jonasbjurel/RailWayHW/Canbus/railpican/railpican-P1A/partlist-Elfa.xls

Quantity | Distrelec Article Number | Reference | Manufacturer | Manufacturer Article Number | Name | Availability | Stock | Expired On | orderCode | My Single Price | My Subtotal
2 | 16569347 |  | Hitano | HB2H561K-L515B | Capacitor 560 pF 500 VDC 5 mm | 24 h | 1079 |  | 1001183267 | Skr0.95 | Skr1.90
2 | 16569149 |  | Hitano | TCH2H220J-L515B | Capacitor 22 pF 500 VDC 5 mm | 24 h | 4353 |  | 1001183267 | Skr0.91 | Skr1.81
1 | 16059249 |  | Vishay | MBB02070C1802FCT00 | Resistor 18 kOhm 0.6 W ± 1 % | 24 h | 5634 |  | 1001183267 | Skr0.82 | Skr0.82
2 | 16059231 |  | Vishay | MBB02070C4701FCT00 | Resistor 4.7 kOhm 0.6 W ± 1 % | 24 h | 41576 |  | 1001183267 | Skr0.83 | Skr1.65
1 | 16059239 |  | Vishay | MBB02070C1002FCT00 | Resistor 10 kOhm 0.6 W ± 1 % | 24 h | 7276 |  | 1001183267 | Skr0.82 | Skr0.82
2 | 16059189 |  | Vishay | MBB02070C1000FCT00 | Resistor 100 Ohm 0.6 W ± 1 % | 24 h | 10312 |  | 1001183267 | Skr0.83 | Skr1.65
1 | 16059191 |  | Vishay | MBB02070C1200FCT00 | Resistor 120 Ohm 0.6 W ± 1 % | 24 h | 34365 |  | 1001183267 | Skr0.82 | Skr0.82
2 | 16059214 |  | Vishay | MBB02070C1001FCT00 | Resistor 1 kOhm 0.6 W ± 1 % | 24 h | 749017 |  | 1001183267 | Skr0.83 | Skr1.65
1 | 17451701 |  | IQD | LFXTAL003240 | Quartz HC49/4H 16 MHz | 24 h | 3748 |  | 1001183267 | Skr2.88 | Skr2.88
1 | 17309560 |  | ST | L78S05CV | Linear voltage regulator 5 V TO-220 | 24 h | 1830 |  | 1001183267 | Skr6.82 | Skr6.82
1 | 17387002 |  | Microchip | MCP2515-I/P | Controller IC CAN v2.0B / SPI DIL-18 | 24 h | 63 |  | 1001183267 | Skr15.60 | Skr15.60
1 | 17386817 |  | Microchip | MCP2551-I/P | Transceiver IC CAN High Speed DIL-8 | 24 h | 2438 |  | 1001183267 | Skr8.74 | Skr8.74
4 | 12450887 |  | Fischer Elektronik | CAB4GS | Jumper 2.54 mm Black | 24 h | 1551 |  | 1001183267 | Skr1.13 | Skr4.50
1 | 14370219 |  | Prostar | SS-1X36-T1-7/3MM | Straight pin header Male 36 | 24 h | 26933 |  | 1001183267 | Skr6.14 | Skr6.14
1 | 14416350 |  | TE Connectivity | 5747844-4 | D-Sub female 9P, Female | 24 h | 762 |  | 1001183267 | Skr25.40 | Skr25.40
1 | 17501224 |  | Everlight Electronics | 264-7SURD/S530-A3 | LED 3 mm (T1) Red | 24 h | 23316 |  | 1001183267 | Skr3.26 | Skr3.26
1 | 17510152 |  | Vishay Telefunken | TLHG 4600 | LED 3 mm (T1) Green | 24 h | 3601 |  | 1001183267 | Skr2.21 | Skr2.21
2 | 17003619 |  | No Brand | 1N5401 | Rectifier diode 100 V 3 A DO-201 | 24 h | 5433 |  | 1001183267 | Skr1.49 | Skr2.97
2 | 11046377 |  | Rubycon | 100PX47MT78X11.5 | Aluminium Electrolytic Capacitor 47 uF 100 VDC | 24 h | 488 |  | 1001183267 | Skr2.91 | Skr5.82
2 | 16716492 |  | Jamicon | TKP0R1M2AD11ME4 | Aluminium Electrolytic Capacitor 100 nF 100 VDC | 24 h | 1646 |  | 1001183267 | Skr0.77 | Skr1.54
1 | 14833634 |  | Phoenix Contact | 1715048 | PCB Terminal Block Pitch 5 mm Horizontal 4P | 24 h | 263 |  | 1001183267 | Skr15.00 | Skr15.00
1 | 17558604 |  | Fischer Elektronik | FK 242 SA 220 O | Heat sink 15.2 mm 26 K/W black anodised | 24 h | 272 |  | 1001183267 | Skr6.34 | Skr6.34
1 | 14384015 |  | Preci-Dip | 803-87-040-10-001101 | Pin header Female 40 | 24 h | 228 |  | 1001183267 | Skr31.40 | Skr31.40
1 | 17503121 |  | Vishay Telefunken | TLHY 4400 | LED 3 mm (T1) Yellow | 24 h | 2714 |  | 1001183267 | Skr1.82 | Skr1.82
