jonasbjurel/RailWayHW/Canbus/railpican/railpican-P1A/railpican.kicad_pcb

## KiCad design Canbus/railpican/railpican-P1A/railpican.kicad_pcb (2019-11-24)

Schematic: railpican.sch, RAIL-PICAN

Parts:
C1: CONN_02X20; Socket_Strip_Straight_2x20
C2: 0.1uF; CP_Radial_D5.0mm_P2.00mm
C3, C8: 47uF; CP_Radial_D8.0mm_P3.50mm
C4, C5: 560pF; C_Disc_D8.0mm_W2.5mm_P5.00mm
C6, C7: 22 pF; C_Disc_D8.0mm_W2.5mm_P5.00mm
D1, D3: 1N5401; D_DO-201_P12.70mm_Horizontal
D2: GREEN; LED_D3.0mm
D4: YELLOW; LED_D3.0mm
D5: RED; LED_D3.0mm
J1: Screw_Terminal_1x04; TerminalBlock_Pheonix_MKDS1.5-4pol
J2: DB9; DB9FD
JP1: JP1; Pin_Header_Straight_1x03_Pitch2.54mm
JP2: JP2; Pin_Header_Straight_1x02_Pitch2.54mm
JP3: JP3; Pin_Header_Straight_1x03_Pitch2.54mm
JP4: JP4; Pin_Header_Straight_1x03_Pitch2.54mm
R1: 18k; R_Box_L8.4mm_W2.5mm_P5.08mm
R2, R4: 4k7; R_Box_L8.4mm_W2.5mm_P5.08mm
R3: 10k; R_Box_L8.4mm_W2.5mm_P5.08mm
R5, R8, R10: 1k; R_Box_L8.4mm_W2.5mm_P5.08mm
R6, R7: 100; R_Box_L8.4mm_W2.5mm_P5.08mm
R9: 120; R_Box_L8.4mm_W2.5mm_P5.08mm
U1: MCP2515-E/ST-DIP; DIP-18_W7.62mm
U2: 78S05; TO-220
U3: MCP2551-I/P; DIP-8_W7.62mm
Y1: Crystal; Crystal_HC49-4H_Vertical
c1: 0.1uF; CP_Radial_D5.0mm_P2.00mm

Connections:
+12V: D1.2 (A), J1.4, J2.9
CANH: J1.3, JP2.2, JP3.2, R7.1, U3.7 (CANH)
CANL: J1.2, JP1.2, R6.1, R9.2, U3.6 (CANL)
GND: C1.6, C1.9, C1.14, C1.20, C1.30, C1.34, C1.39, C2.2, C3.2, C4.2, C5.2, C6.2, C7.2, C8.2, J1.1, JP4.2, R1.2, R4.2, R5.1, R8.1, R10.1, U1.9 (VSS), U2.2, U3.2 (VSS), c1.2
unnamed: C3.1, D3.2 (A), D4.2 (A), U2.3
unnamed: C4.1, R6.2
unnamed: C5.1, R7.2
unnamed: C8.1, D1.1 (K), U2.1
unnamed: D2.1 (K), R5.2
unnamed: D4.1 (K), R8.2
unnamed: D5.1 (K), R10.2
unnamed: J2.2, JP1.3, JP4.1
unnamed: J2.3, JP3.1, JP4.3
unnamed: J2.5, JP1.1
unnamed: J2.7, JP3.3
unnamed: JP2.1, R9.1
unnamed: R1.1, R3.2, U1.2 (RXCAN)
unnamed: R3.1, U3.4 (RXD)
unnamed: R4.1, U3.8 (Rs)
unnamed: U1.1 (TXCAN), U3.1 (TXD)
OSC1: C6.1, U1.8 (OSC1), Y1.1
OSC2: C7.1, U1.7 (OSC2), Y1.2
PI_3V3: C1.1, C1.17, C2.1, R2.2, U1.18 (VDD)
PI_5V: C1.2, C1.4, D2.2 (A), D3.1 (K), U3.3 (VDD), c1.1
PI_SPI_MISO: C1.21, U1.15 (SO)
PI_SPI_MOSI: C1.19, U1.14 (SI)
PI_SPI_SCLK: C1.23, U1.13 (SCK)
RST: R2.1, U1.17 (~RESET)
~PI_SPI_CE0: C1.24, U1.16 (~CS)
~PI_SPI_CE1: C1.26, D5.2 (A)

Notes on the sheet:
PI connect
Power supply
Timing
CAN Activity
CANBus Logic
CAN-Interface
Control
ODBII
TERMINATION
Description
Jumper settings:
LED description:
Debug
D5 - RED: CANBUS RX/TX activity
D4 - YELLOW: +12V CANBUS Power (PI Powered by CANBUS)
D2 - GREEN: +5V PICAN HAT POWER
JP2 - CANBUS Termination: Open-No termination; Closed-R120 termination
CANBUS Termination:
CANBUS DB9 Pinout standard:
JP1:
JP3:
JP4:
(1-2)
(2-3)
2-GND; 3-CANH; 5-CANL; 9-12V+
2-CANL; 3-GND; 7-CANH; 9-12V+
DB9:
1-GND; 2-CANL; 3-CANH; 4-12V+
Screw terminal:
N/A
T.B.D.

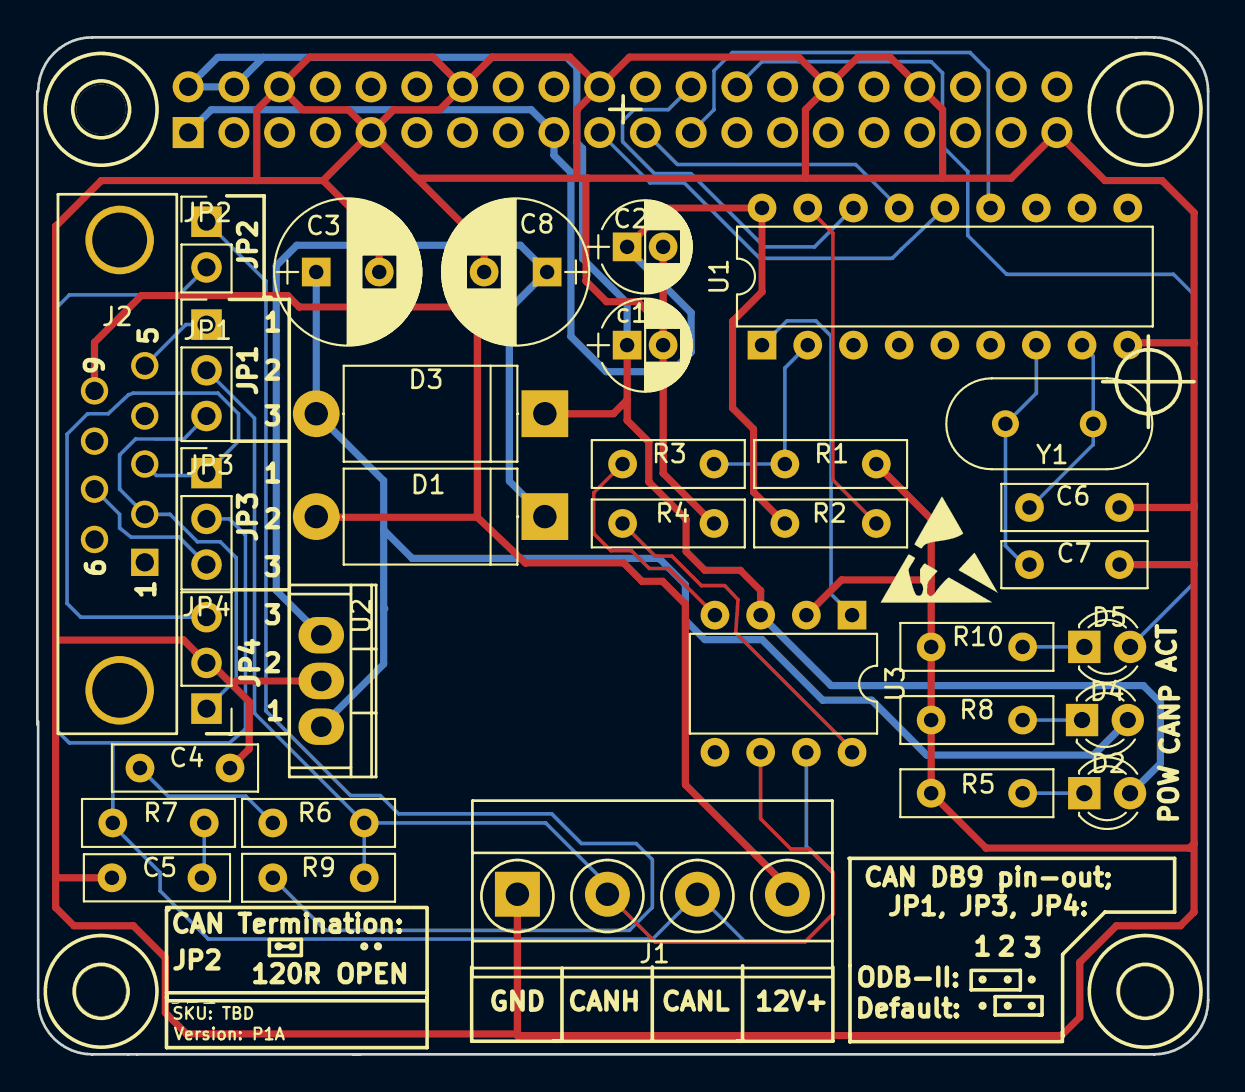
[picture p6: board railpican.kicad_pcb from above]

Board: 2 copper layers, 65.0 x 56.5 mm, 38 parts (1 on the bottom side), 30 nets.

Other parts of the board:
H1, H2, H3, H4: DRILL; dsk-drill-rpi-hat
