jonasbjurel/RailWayHW/hat-design-master/hat-design-master/hat-design.kicad_pcb

## KiCad design hat-design-master/hat-design-master/hat-design.kicad_pcb (2019-11-24)

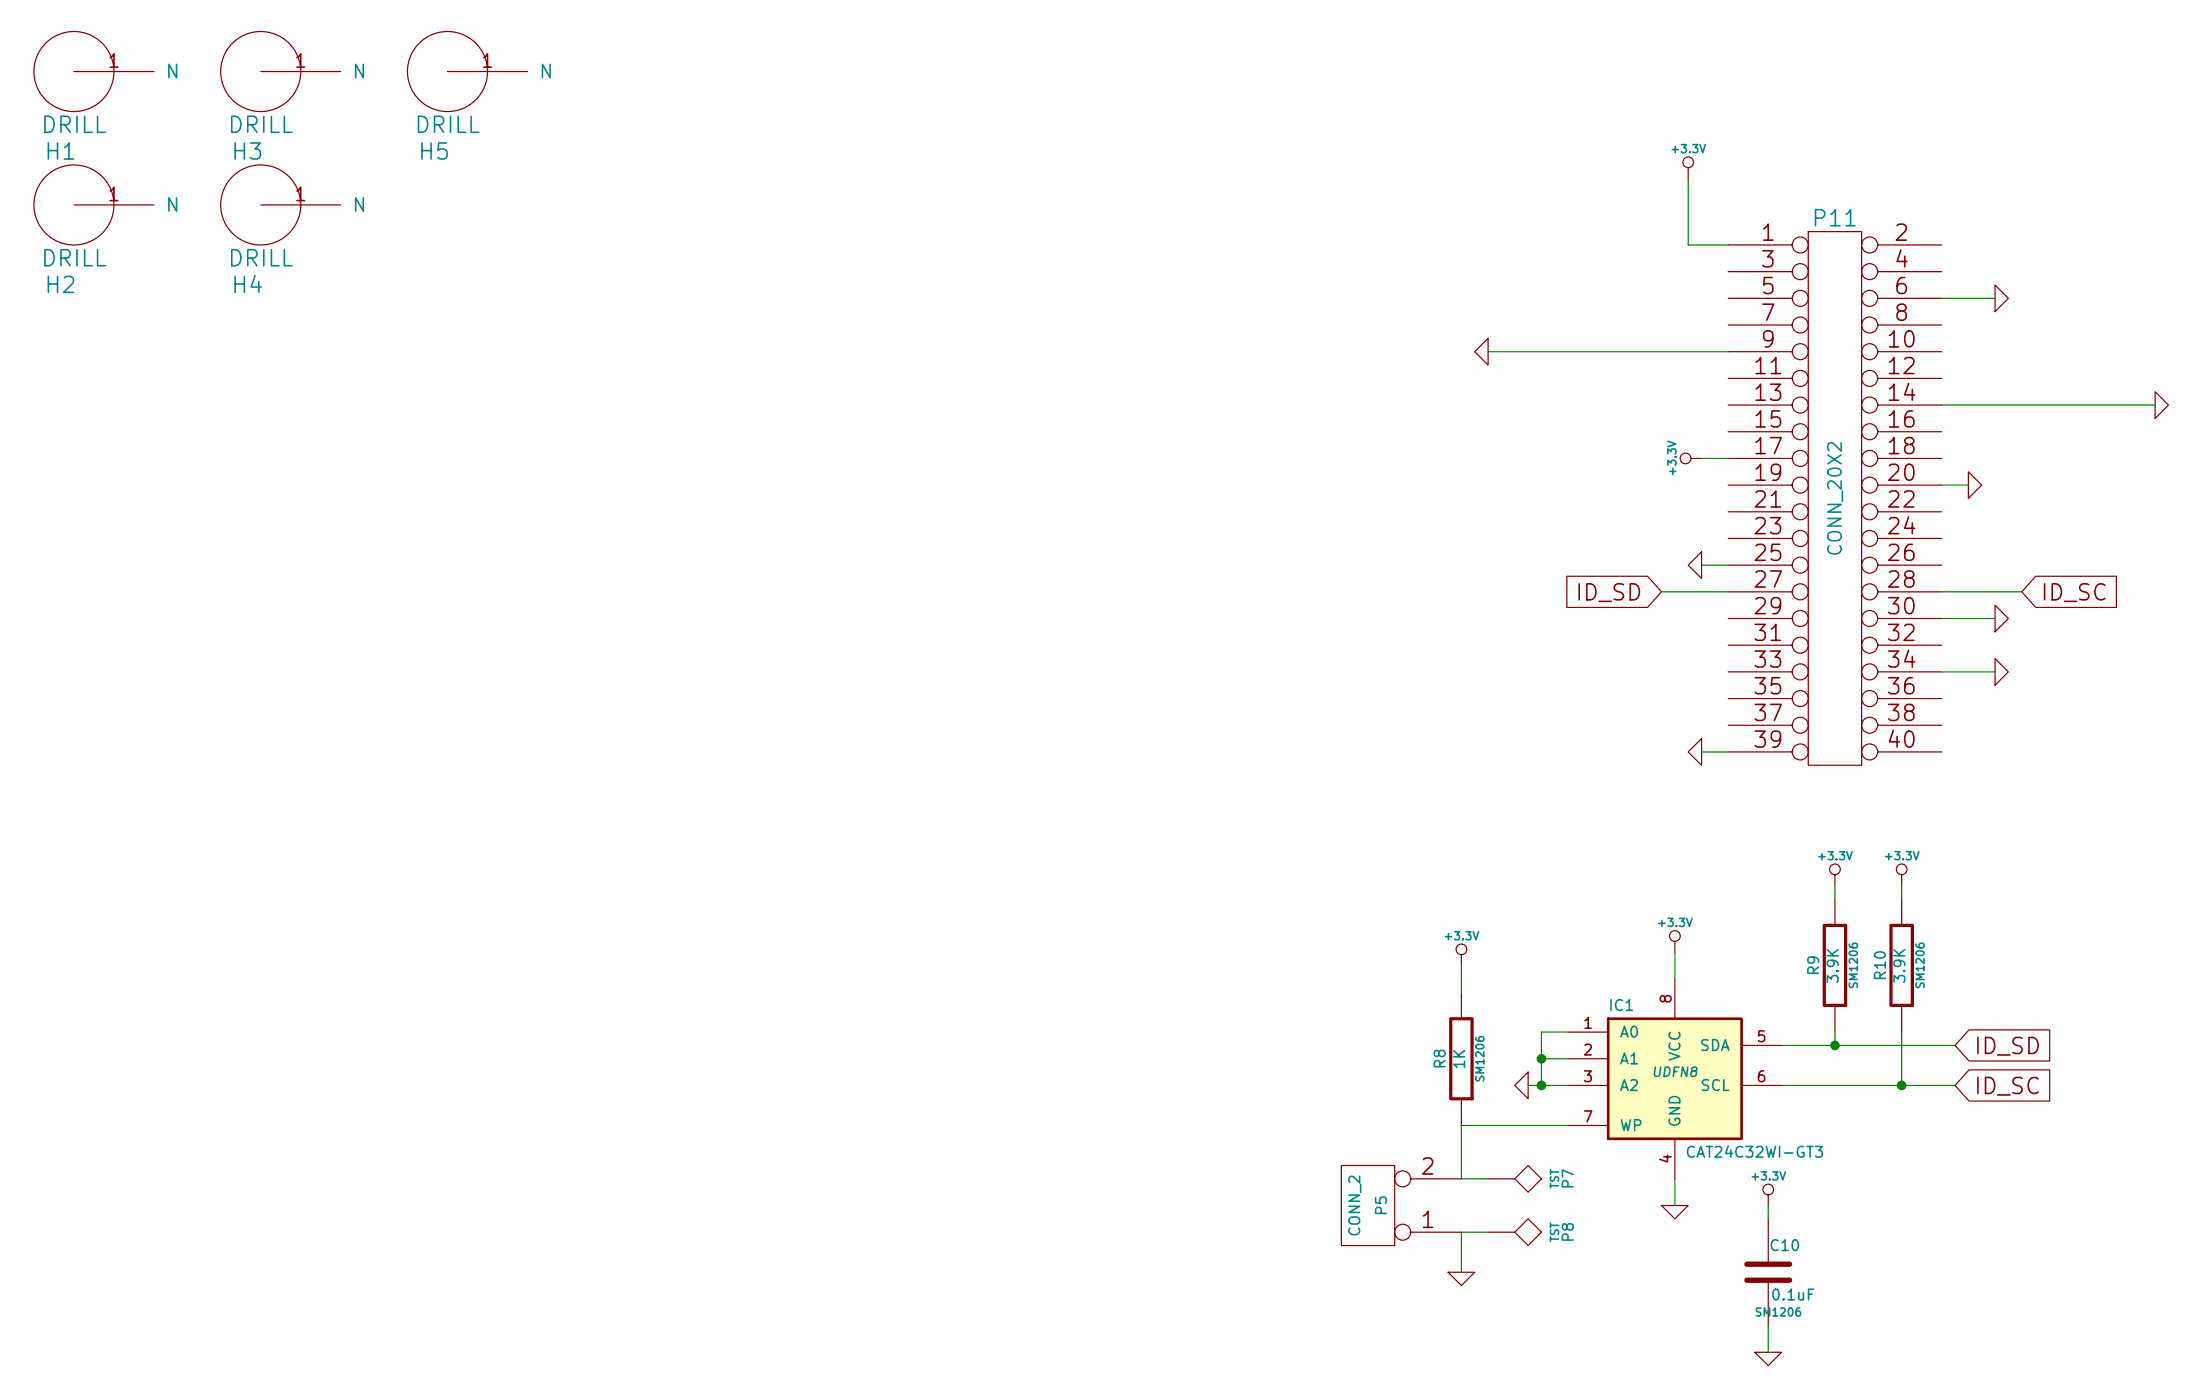
[picture p7: schematic hat-design.sch]

Parts:
C10: 0.1uF; SM1206
H1, H2, H3, H4, H5: DRILL
IC1: CAT24C32WI-GT3; UDFN8
P5: CONN_2
P7, P8: TST
P11: CONN_20X2
R8: 1K; SM1206
R9, R10: 3.9K; SM1206

Connections:
+3.3V: C10.1, IC1.8 (VCC), P11.1, P11.17, R8.2, R9.2, R10.2
GND: C10.2, IC1.1 (A0), IC1.2 (A1), IC1.3 (A2), IC1.4 (GND), P5.1, P8.1, P11.6, P11.9, P11.14, P11.20, P11.25, P11.30, P11.34, P11.39
ID_SC: IC1.6 (SCL), P11.28, R10.1
ID_SD: IC1.5 (SDA), P11.27, R9.1
unnamed: IC1.7 (WP), P5.2 (PM), P7.1, R8.1

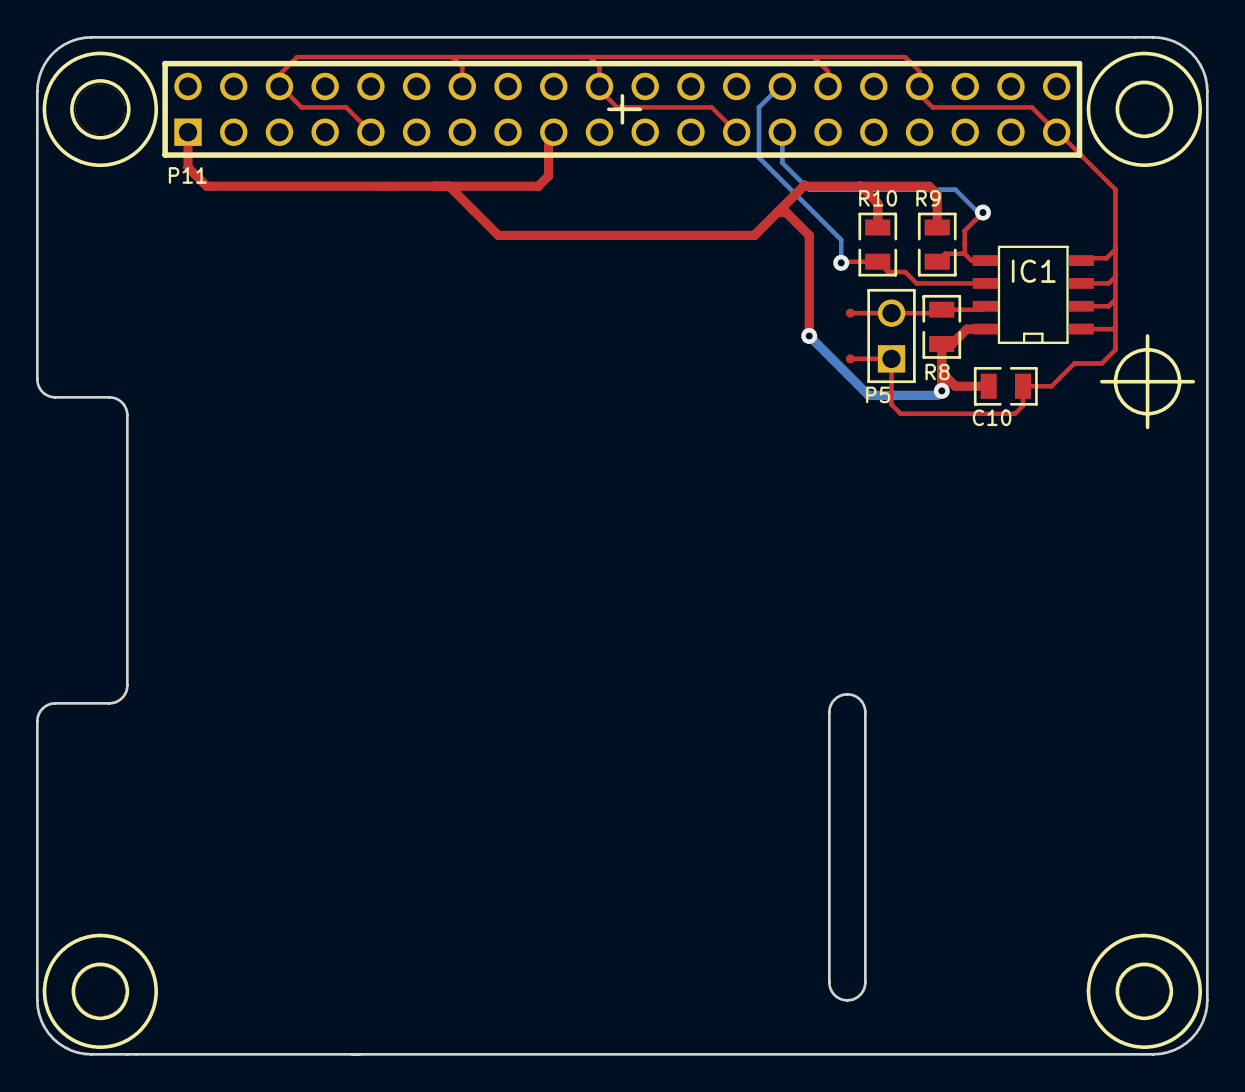
[picture p8: board hat-design.kicad_pcb from above]

Board: 2 copper layers, 65.0 x 56.5 mm, 14 parts (0 on the bottom side), 5 nets.
