jonasbjurel/RailWayHW/(notices)

Notices in the files:
Canbus/railpican/rescue-backup/railpican-2019-11-24-15-14-39.sch:
Licence: Creative Commons (CC BY-SA 4.0)
(c) 2017 Jonas Bjurel
Canbus/railpican/railpican.kicad_pcb:
Licence: (CC BY-SA 4.0)
